Shyri/gba-bt-hid/(threads)

Thread 1 (2019-09-21):

Video support?

earithramir, 2019-09-21:
Hi, great project.
I would like to know does this make the device a pure HID input device or will it be able to receive data too, e.g. video sound.
I would like to use it as a replacement for GBA link cable, will that be possible?

Shyri, 2019-09-25:
Hi @earithramir
It just acts as a pure HID device so from the other devices it is seen as a generic gamepad. About streaming video and sound from other device to the GBA, this would not be enough. I don't know if that would be even possible. My project uses uart at 115000 baud, maybe you can stream some video at that rate but that should be encoded and compressed and GBA would need to decode it somehow, and that ROM for sure is not going to fit into a 'multibootable' ROM. Other communication modes can reach 2Mbit/s so maybe there's hope I don't know.

A different thing would be creating a wireless replacement for GBA cable. This is technically possible but this project is not good for that. For that kind of project, I'd say you would need just some simple RF communicator, you would have two data lines (input/ouput) to read and write from and to the GBA on each side. Maybe you'd need some custom way of wrapping information and regenerate the clock signal on each side. Also note, from what I've read, link cable communications are very sensitive to timing, so very fast wireless communications wold be required.

I hope this answers your questions

earithramir, 2019-09-27:
Hi thank you for taking the time to answer my question and in detail too.
Reason for asking is i'm a big fan of the zelda series on nintendo and currently own a wii and w wii u because the wii u does not support the GBA communication, only as a hid controller. Was hoping to use this project to bring the GBA support to the wii and be able to let go of the Wii (as 95% of the games are fully functional on the Wii U).

Thanks again!

Closed 2020-04-26.

Thread 2 (2020-04-22):

ESP-IDF version & btstack missing files

Shadow7369124, 2020-04-22:
Hello,

What version of ESP-IDF are you using ?

I've spent 5 hours trying to "make flash" but I always get errors, mostly concerning the btstack files that are missing.

Thanks by advance

Regards

Shyri, 2020-04-23:
Hi @Shadow7369124 Could you please paste the log output here to try to understand the problem? Thanks!

Shadow7369124, 2020-04-23:
Hello,

Thanks for your reply.

I'll post the logs tomorrow if that's fine, error is the include files in the main.c like btstack.h not found and also freertos.

I've managed to run main.c by removing "hc05.c" and "uart.c", just the multiboot part and that worked :)
I had to rename the main function in main.c to "app_main()" tho.

Regards

Shyri, 2020-04-25:
@Shadow7369124 I realized the esp-idf I was using was a mix of several things result of being working in other different projects. So I tried a clean esp-idf v3.3.2 install and realized it was not compiling and fixed it in dev branch. Using v.3.3.2 and latest btstack master branch it builds with the canges I pushed to dev branch and it flashes correctly to the ESP32. I still need to test it with the GBA. I'll try to test tomorrow and merge it to master and update the readme. Thanks for pointing it out

Shadow7369124, 2020-04-25:
Great thanks, I'll try that.
Also, could I contact you elsewhere if possible ? Like discord.

Shyri, 2020-04-26:
@Shadow7369124 I could confirm that setup is working with the GBA. It throws some warnings during compilation but it is fully working. I'm going to merge and update readme and instructions. Most probably I'll also work on make it compatible with esp-idf v4 because I need it for other projects and I don't want to be changing installations every time.

Sure you can find me in Discord shyri#5614

Shadow7369124, 2020-04-26:
Thanks!
I've added you on dis :)

Closed 2020-06-06.

Thread 5 (2020-10-14):

Are there files missing?

giltesa, 2020-10-14:
Hello Shyri,
Are you sure the project include all required files for building it? I can't make it.
Thanks for your help.

_C:\Users\giltesa\esp\esp32>idf.py build
CMakeLists.txt not found in project directory C:\Users\giltesa\esp\esp32_

giltesa, 2020-11-02:
Nothing? :-(

Shyri, 2020-11-04:
Sorry @giltesa I only tried on mac and actually have a big mess regarding esp framework installations in my computer. I'll try in a brand new installation to test if something is missing

giltesa, 2020-11-20:
Thanks @Shyri so much, I have order some boards and I will really appreciate if you can help me with that.

https://giltesa.com/wp-content/uploads/2020/10/GBA-Wireless-Gamepad-T.jpg

Shyri, 2020-11-22:
@giltesa nice looking board! Is it intended to fit into the first party wireless gba link?

After checking in my local. Everything works, I'm using mac but that should make no difference. I've read through my README file and I realized I'm not giving clear instructions on how to build and flash the code so let me explain:

The build system for this project is not CMake that is why it's complaining it can't find a CMakeList.txt file. You should build it using `make`. Steps would be:

navigate to your C:\Users\giltesa\esp\esp32 (which I assume is where you have the gba-bt-hid esp32 code, if you do an `ls` or `dir` you should see a "Makefile". Then run this command:

`make menuconf`
That will prompt a menu where you can set the device serial port that will be used to flash navigating through Serial Flasher Config -> Default Serial Port. After saving run this command:

`make flash monitor`

it will build the project and then flash to the device set previously in menuconf. `monitor` tells it to show the log in your terminal so you can check the multiboot procedure is executing correctly if you have the set up connected to your gba.

Let me know if this helps.
Can't wait to see how that board works :)

giltesa, 2020-11-28:
Thanks so much @Shyri

I have tried to write the firmware but I haven't got yet, tomorrow I'm going to try it again.
Anyway. Yes, the board is the exact size for the case of the GBA Wireless Adapter. I have received the PCBs today and I assembled a board. It works well, I can program the board and execute a blink code. When I connect the board to the GBA, It doesn't work, but I think it's because the ESP32 is trying to turn on everything (WiFi, etc.), so I hope It works well after burn the firmware. I will inform you about the result :)

You can see here some pictures and videos:
https://twitter.com/giltesa/status/1332673334656593924

Thread 6 (2021-09-07):

This doesn't seem to fit that housing shown.

Jackinator675, 2021-09-07:
I ordered an esp32 module and it is no where near narrow enough to fit inside a Gameboy GameCube link enclosure. How did you fit yours inside that enclosure?

Shyri, 2021-09-13:
Hi @Jackinator675 ,
Please read here how to fit the ESP into the enclosure

https://hackaday.io/project/166654/instructions

Thread 7 (2022-06-13):

Can an Arduino Due load the ROM onto the W25Q32 flash chip?

AndrewMascolo, 2022-06-13:
Hi,

I am trying to do something similar to your project, but I've never tried to program an external flash chip before. I was wondering if you can walk me through it a bit? I have an Arduino Due, is this enough to right the ROM data to the flash chip or do I need to use something else like a raspberry pi?

I see that you mentioned the Stellaris Launchpad, but was this for the flash chip itself or for the ESP32 module?

Shyri, 2022-06-26:
Hi Andrew,
Sorry for the late reply.
I'm not familiar with Arduino Due, I did a quick search and I think it has 512KB flash so it should be ok. The problem with the Arduino Uno I had is it was 32KB and since the gba rom must be embedded in the program as a byte array it didn't fit the memory. I used Stellaris Launchpad for this purpose since it was what I had on hand and with 256KB flash memory it was enough to hold the gba rom data in a byte array.
I guess Arduino Due would probably run this code out of the box: [gba-hid-fw-flasher.ino](https://github.com/Shyri/gba-bt-hid/blob/master/arduino-rom-flasher/gba-hid-fw-flasher.ino)

When I migrated all this to ESP32 I just used a regular ESP32 programmer for convenience.
I hope this helps you in your project :) If you make it public I'd love to hear about it.
