Shyri/gba-bt-hid/circuit/GBA-BT-HID.kicad_pcb

## KiCad design circuit/GBA-BT-HID.kicad_pcb (2019-06-13)

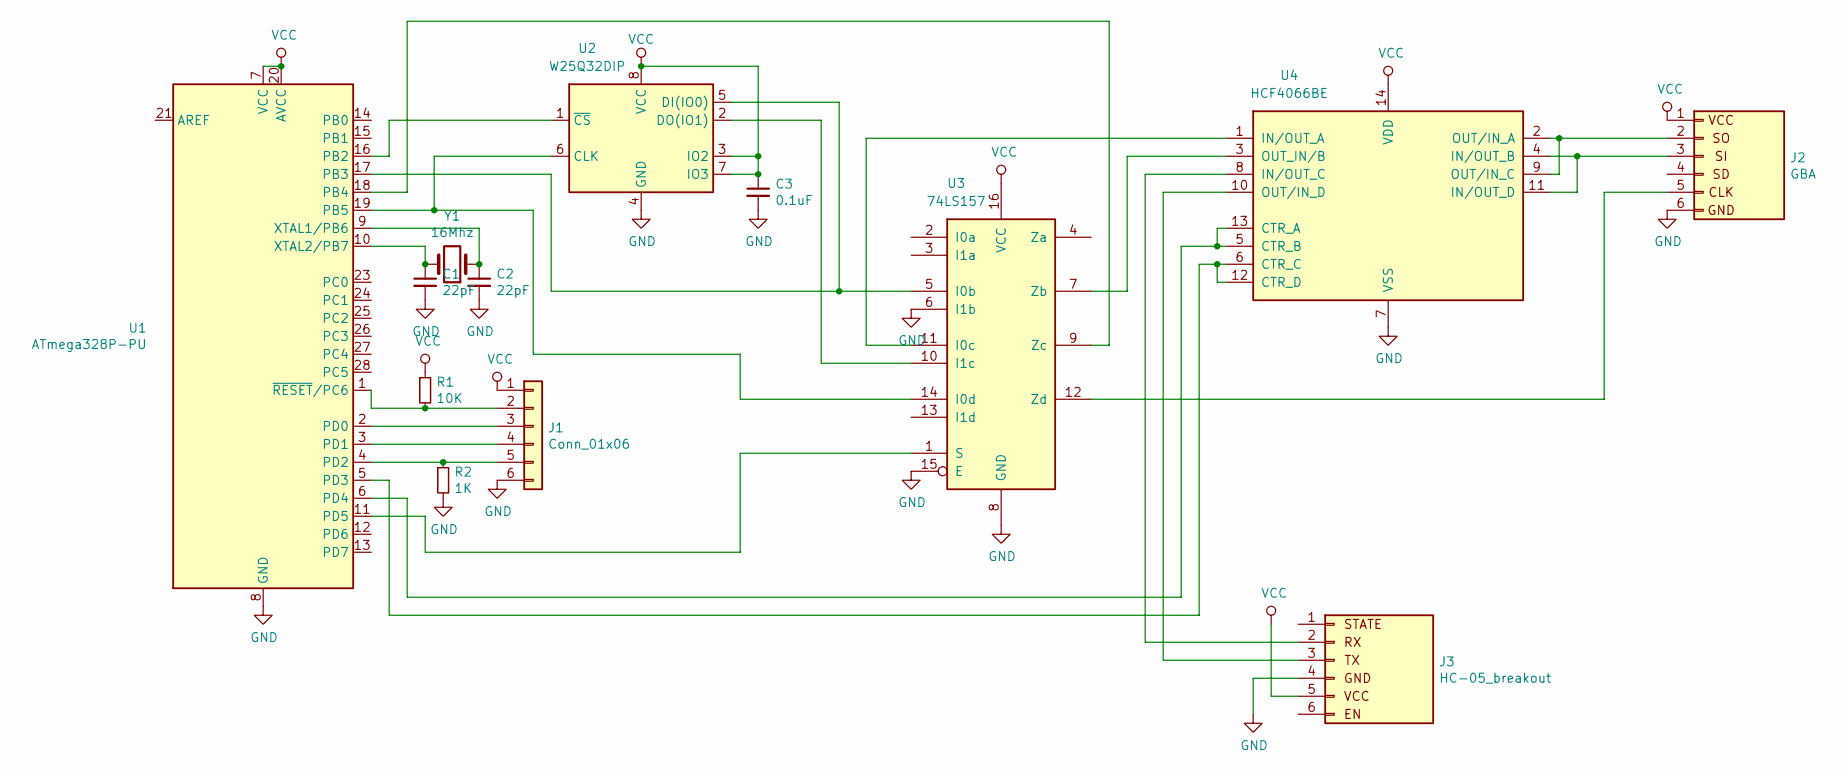
[picture p5: schematic GBA-BT-HID.sch]

Parts:
C1, C2: 22pF; C_Disc_D4.7mm_W2.5mm_P5.00mm
C3: 0.1uF; C_Disc_D4.7mm_W2.5mm_P5.00mm
J1: Conn_01x06; PinSocket_1x06_P2.00mm_Vertical
J2: GBA; PinSocket_1x06_P2.00mm_Vertical
J3: HC-05_breakout
R1: 10K; R_Axial_DIN0207_L6.3mm_D2.5mm_P10.16mm_Horizontal
R2: 1K; R_Axial_DIN0207_L6.3mm_D2.5mm_P10.16mm_Horizontal
U1: ATmega328P-PU; DIP-28_W7.62mm
U2: W25Q32DIP; DIP-8_W7.62mm
U3: 74LS157; DIP-16_W7.62mm
U4: HCF4066BE; DIP-14_W7.62mm
Y1: 16Mhz; Resonator-2Pin_W10.0mm_H5.0mm

Connections:
GND: C1.2, C2.2, C3.2, J1.6, J2.6 (GND), J3.4, R2.2, U1.8 (GND), U1.22 (GND), U2.4 (GND), U3.6 (I1b), U3.8 (GND), U3.15 (E), U4.7 (VSS)
unnamed: C1.1, U1.10 (XTAL2/PB7), Y1.2
unnamed: C2.1, U1.9 (XTAL1/PB6), Y1.1
unnamed: J1.2, R1.2, U1.1 (~RESET~/PC6)
unnamed: J1.3, U1.2 (PD0)
unnamed: J1.4, U1.3 (PD1)
unnamed: J1.5, R2.1, U1.4 (PD2)
unnamed: J2.2 (SO), U4.2 (OUT/IN_A), U4.9 (OUT/IN_C)
unnamed: J2.3 (SI), U4.4 (IN/OUT_B), U4.11 (IN/OUT_D)
unnamed: J2.5 (SC), U3.12 (Zd)
unnamed: J3.2, U4.8 (IN/OUT_C)
unnamed: J3.3, U4.10 (OUT/IN_D)
unnamed: U1.5 (PD3), U4.6 (CTR_C), U4.12 (CTR_D)
unnamed: U1.6 (PD4), U4.5 (CTR_B), U4.13 (CTR_A)
unnamed: U1.11 (PD5), U3.1 (S)
unnamed: U1.16 (PB2), U2.1 (~CS)
unnamed: U1.17 (PB3), U2.5 (DI(IO0)), U3.5 (I0b)
unnamed: U1.18 (PB4), U3.9 (Zc)
unnamed: U1.19 (PB5), U2.6 (CLK), U3.14 (I0d)
unnamed: U2.2 (DO(IO1)), U3.10 (I1c)
unnamed: U3.7 (Zb), U4.3 (OUT_IN/B)
unnamed: U3.11 (I0c), U4.1 (IN/OUT_A)
VCC: C3.1, J1.1, J2.1 (Vcc), J3.5, R1.1, U1.7 (VCC), U1.20 (AVCC), U2.3 (IO2), U2.7 (IO3), U2.8 (VCC), U3.16 (VCC), U4.14 (VDD)

Board: 2 copper layers, 13 parts (0 on the bottom side), 23 nets, no tracks yet.
