Shyri/gba-bt-hid/arduino-rom-flasher/gba-hid-fw-flasher.ino

// WARNING: THIS PROGRAM CAN ONLY BE RAN IN A MICROCONTROLLER WITH LARGE FLASH STORAGE, NOT SUITABLE FOR NORMAL ARDUINO
#include <SPI.h>

// Remove ROM header and paste remaining rom as byte array
const PROGMEM uint8_t rom[] = {
0x06, 0x00, 0x00, 0xEA, 0x00, 0x00, 0x00, 0x00, 0x00, 0x00, 0x00, 0x00, 0x00, 0x00, 0x00, 0x00, // 0x00
0x00, 0x00, 0x00, 0x00, 0x00, 0x00, 0x00, 0x00, 0x00, 0x00, 0x00, 0x00, 0x00, 0x00, 0x00, 0x00, // 0x10 
0x01, 0x03, 0xA0, 0xE3, 0x08, 0x02, 0x80, 0xE5, 0x12, 0x00, 0xA0, 0xE3, 0x00, 0xF0, 0x29, 0xE1, // 0x20
0xB8, 0xD0, 0x9F, 0xE5, 0x1F, 0x00, 0xA0, 0xE3, 0x00, 0xF0, 0x29, 0xE1, 0xB0, 0xD0, 0x9F, 0xE5,  // 0x30
0x01, 0x00, 0x8F, 0xE2, 0x10, 0xFF, 0x2F, 0xE1, 0x2B, 0x48, 0x40, 0x01, 0x0B, 0xD2, 0x78, 0x46,  // 0x40
0x40, 0x01, 0x0D, 0xD3, 0x02, 0x22, 0x12, 0x06, 0x28, 0x4B, 0x9B, 0x1A, 0x16, 0x1C, 0x91, 0x00,  // 0x50
0x00, 0xF0, 0x3C, 0xF8, 0x30, 0x47, 0x40, 0x21, 0x09, 0x03, 0xC8, 0x01, 0x00, 0xF0, 0x2B, 0xF8,  // 0x60
0x23, 0x48, 0x24, 0x49, 0x09, 0x1A, 0x00, 0xF0, 0x26, 0xF8, 0x23, 0x48, 0x23, 0x49, 0x09, 0x1A,  // 0x70
0x00, 0xF0, 0x21, 0xF8, 0x22, 0x49, 0x23, 0x4A, 0x23, 0x4C, 0x00, 0xF0, 0x26, 0xF8, 0x23, 0x49,  // 0x80
0x23, 0x4A, 0x24, 0x4C, 0x00, 0xF0, 0x21, 0xF8, 0x23, 0x4A, 0x24, 0x49, 0x53, 0x1A, 0x02, 0xD0,  // 0x90
0x23, 0x4A, 0x00, 0xF0, 0x1B, 0xF8, 0x23, 0x49, 0x23, 0x4A, 0x24, 0x4C, 0x00, 0xF0, 0x15, 0xF8,  // 0xA0
0x23, 0x49, 0x24, 0x48, 0x08, 0x60, 0x24, 0x4B, 0x00, 0xF0, 0x0E, 0xF8, 0x00, 0x20, 0x00, 0x21,  // 0xB0
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
  
  do {
    digitalWrite(SS_PIN, LOW);
    SPI.transfer(0x06);
    digitalWrite(SS_PIN, HIGH);
    
    if(checkWEL()) {
      digitalWrite(SS_PIN, LOW);
      SPI.transfer(0x02);
      
      SPI.transfer((page >> 8) & 0xFF);
      SPI.transfer(page & 0xFF);
      SPI.transfer(0x00);

      if(page == 0) {
        SPI.transfer((romSize >> 24) & 0xFF);
        SPI.transfer((romSize >> 16) & 0xFF);
        SPI.transfer((romSize >> 8) & 0xFF);
        SPI.transfer(romSize & 0xFF);
        for(int i = 0; i < 0x100 - startByte; i++) {
          SPI.transfer(rom[0x100 * page + i]);
          byteCounter--;
          if(byteCounter == 0) {
            break;
          }
        }
      } else {
        for(int i = 0; i < 0x100; i++) {
          SPI.transfer(rom[0x100 * page + i - startByte]);
          byteCounter--;
          if(byteCounter == 0) {
            break;
          }
        }
      }
      
      digitalWrite(SS_PIN, HIGH);
      page++;
      
      waitWhileBusy();
    } else {
      Serial.println("Flashing firmware failed!");
      return;
    }
  } while(byteCounter > 0);
  
  Serial.println("Success!");
}

bool checkWrite() {
  Serial.println("Checking...");
  
  digitalWrite(SS_PIN, LOW);
  
  SPI.transfer(0x03);
  
  SPI.transfer(0x00);
  SPI.transfer(0x00);
  SPI.transfer(0x00);

  int romSize = sizeof(rom);
  byte size1 = SPI.transfer(0x00);
  byte size2 = SPI.transfer(0x00);
  byte size3 = SPI.transfer(0x00);
  byte size4 = SPI.transfer(0x00);

  int readRomSize = (size1 << 24) | (size2 << 16) | (size3 << 8) | size4;

  if(readRomSize != romSize) {
    Serial.print("Check failed: ");
    Serial.print("Rom size read: ");
    Serial.println(readRomSize, HEX);
    Serial.print("should be: ");
    Serial.println(romSize, HEX);
  }
  
  for(int i = 0; i < romSize; i++) {
    int rv = SPI.transfer(0x00);
    if(rv != rom[i]) {
      digitalWrite(SS_PIN, HIGH);
      Serial.print("Check failed: ");
      Serial.print("at: ");
      Serial.println(i, HEX);
      Serial.print("should be: ");
      Serial.println(rom[i], HEX);
      Serial.print("found: ");
      Serial.println(rv, HEX);
      return false;
    }
  }

  digitalWrite(SS_PIN, HIGH);
  
  Serial.println("Check success");
  return true;
}

void dumpRom() {
  digitalWrite(SS_PIN, LOW);
  
  SPI.transfer(0x03);
  
  SPI.transfer(0x00);
  SPI.transfer(0x00);
  SPI.transfer(0x00);

  int j = 0;
  for(int i = 0; i < sizeof(rom); i++) {
    int rv = SPI.transfer(0x00);
    Serial.print("0x");
    Serial.print(rv, HEX);
    Serial.print(" ");
    j++;
    if(j == 16) {
      Serial.println(" ");
      j = 0;
    }
  }

  digitalWrite(SS_PIN, HIGH);
}

void setup() {
  Serial.begin(9600);
  pinMode(SS_PIN, OUTPUT);
  digitalWrite(SS_PIN, HIGH);
  SPI.begin();
  
  Serial.println("GBA-BT-HID Flasher");

  if(!chipErase()) {
    return;
  }

  writeROM();

  if(!checkWrite()) {
    dumpRom();
  }
}

void loop() {
  // put your main code here, to run repeatedly: 
  
}
