Shyri/gba-bt-hid/(commit log)

2019-01-02 Add some modifications to HC-05 test program to know which buttons we want to map
2019-01-03 Add gba rom uart communication to send keys to hc-05
2019-01-20 Fix build things and add new rom to multiboot script
    [multiboot.ino]
2019-01-21 Fix button hold not being sent
    [main.c, multiboot.ino]
2019-01-21 Detect from gba if hc05 is paired to device externally
2019-01-22 Add multiplexing from SPI to UART when multiboot is done
2019-06-13 Add circuit diagram project
    [GBA-BT-HID.kicad_pcb, GBA-BT-HID.sch]
2019-06-14 Add back circuit image
2019-09-12 Create new ESP32 project
2019-09-14 Port multiboot from arduino code to ESP32
2019-09-21 Add esp32 working example for hid over gatt
2019-11-13 gba binary fix pairing state check
    [main.c]
2019-11-13 Add working ESP32 code compatible with HC-05 ready GBA binary
2019-11-14 ESP32 Add connect to last connected device fetaure
2019-12-21 Complete ESP32 implementation
2020-02-22 Clean up ESP32 code
2020-04-25 Fix to make it work with esp-idf v3.3.2
    [hc05.c]
